kaballian/IOT_F26_PROJ/report/forside.tex

\begin{titlepage}
\begin{center}

\vspace*{2cm}



\vspace{1.5cm}

{\huge \textbf{
\hrulefill \\
Internet of things technology \\
\hrulefill
}}

\vspace{1cm}

{\Large \textbf{IOT  mini-project}}

\vspace{2cm}

\resizebox{17cm}{!}{
\begin{tabular}{lllc}
     \textbf{Name} & \textbf{Initials} & \textbf{Student number} & \textbf{Direction} \\
     \toprule
     Alexander Nygaard Thomsen & AT & 201911329 & E \\
     Jeppe Bangshaab Christensen & JBC & 202106888 & CE\\
\end{tabular}
}

\vspace{1.5cm}

{\Large Due date: 26/05/2026}

\vfill

\end{center}
\end{titlepage}
