kaballian/IOT_F26_PROJ/docs/forside.tex

\begin{center}
    \begin{figure}
        \centering
        
        \label{fig:logo}
    \end{figure}

\vspace*{1cm}
\huge  
\textbf{\hrulefill \\ IOT techonolgy mini project proposal\\ \hrulefill}
\Large
\textbf{\\ }
\vspace{0.5cm}

\LARGE
%\textbf{Aarhus Universitet\\}
\vspace{0.7cm}
\resizebox{17cm}{!}{
\begin{tabular}{lllc}
     \multicolumn{4}{c}{}\\
     \\
     \textbf{Name} & \textbf{Initials} & \textbf{Student number} & \textbf{Retning}\\
     \toprule
        Alexander Nygaard Thomsen & AT & 201911329 & E\\
        Jeppe Bangshaab christensen & JBC & 202106888 & CE\\
        
    % \toprule
    % \textbf{Lecturer: }  \\
\toprule
\\
    proposal date: 22/03/2026 \\
\end{tabular}
}
\end{center}
\newpage
