kaballian/IOT_F26_PROJ/IOT_AIR_FILTER_PROJ_pic.png

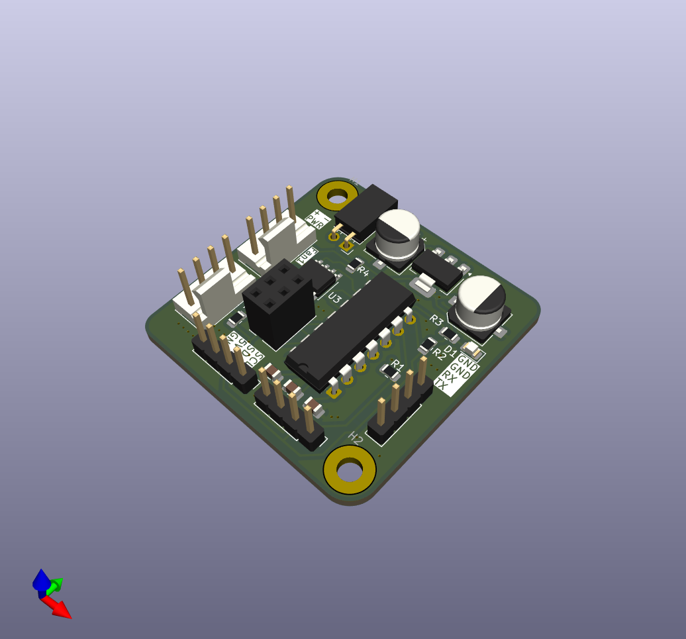
IOT_AIR_FILTER_PROJ_pic.png
