kaballian/IOT_F26_PROJ/IOT_AIR_FILTER_PROJ_REV_B/IOT_AIR_FILTER_PROJ_picture.png

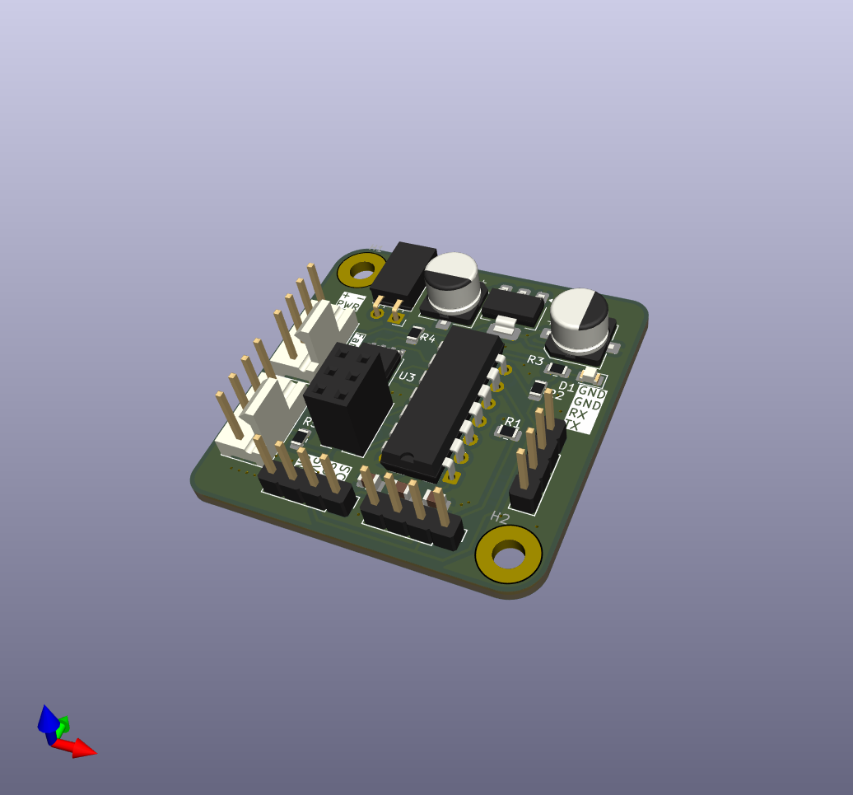
IOT_AIR_FILTER_PROJ_REV_B/IOT_AIR_FILTER_PROJ_picture.png
