kaballian/IOT_F26_PROJ/IOT_AIR_FILTER_SENSOR_SCHEMATIC.png

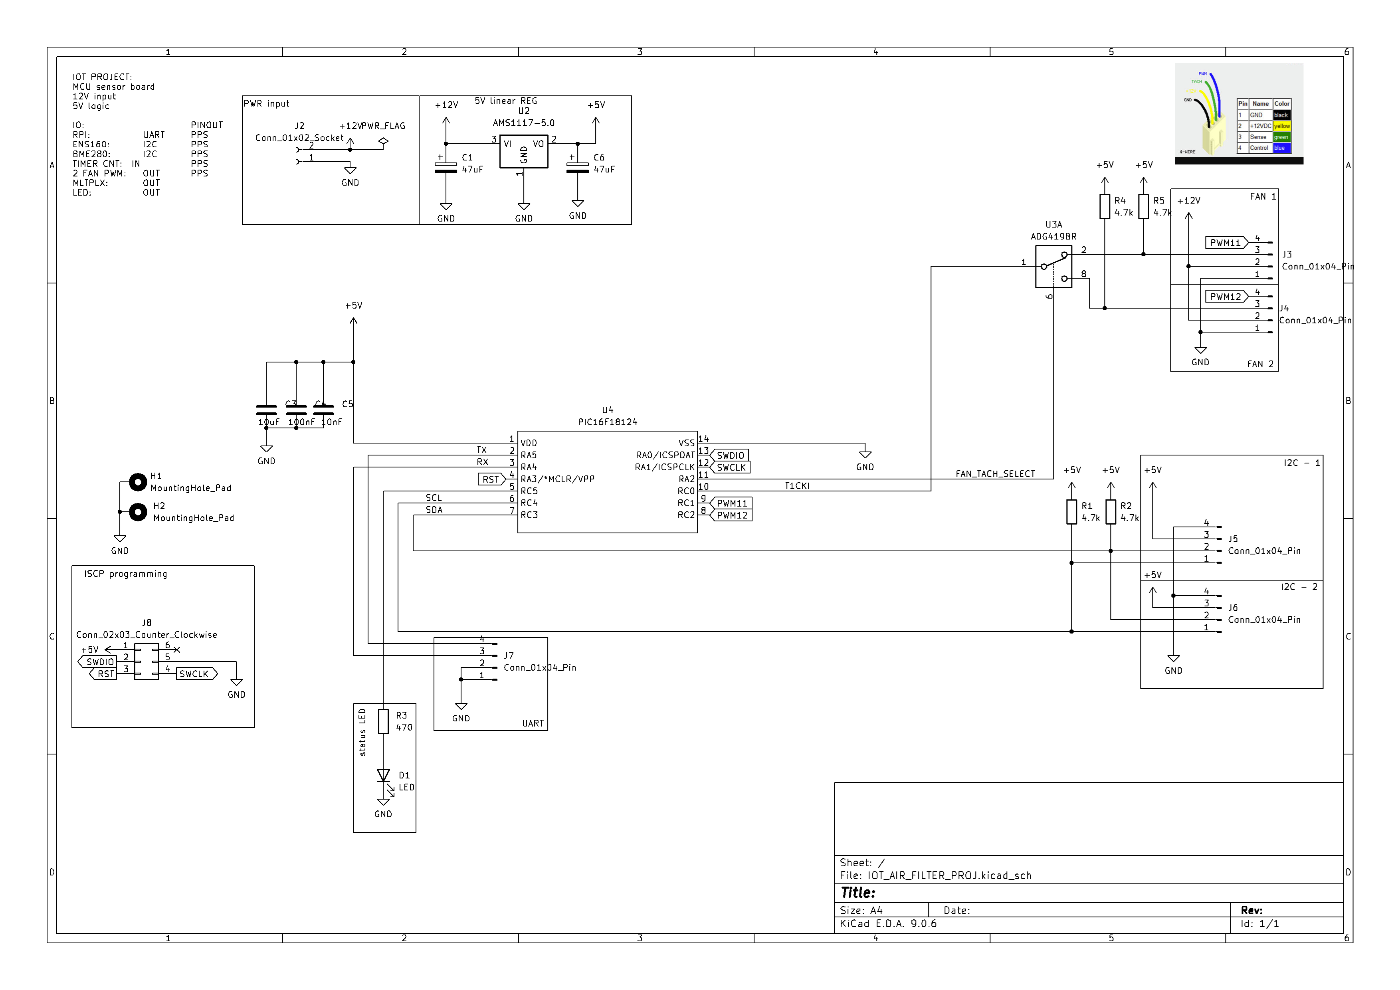
IOT_AIR_FILTER_SENSOR_SCHEMATIC.png
