kaballian/IOT_F26_PROJ/IOT_AIR_FILTER_PROJ_REV_B/subsys_schematic.pdf

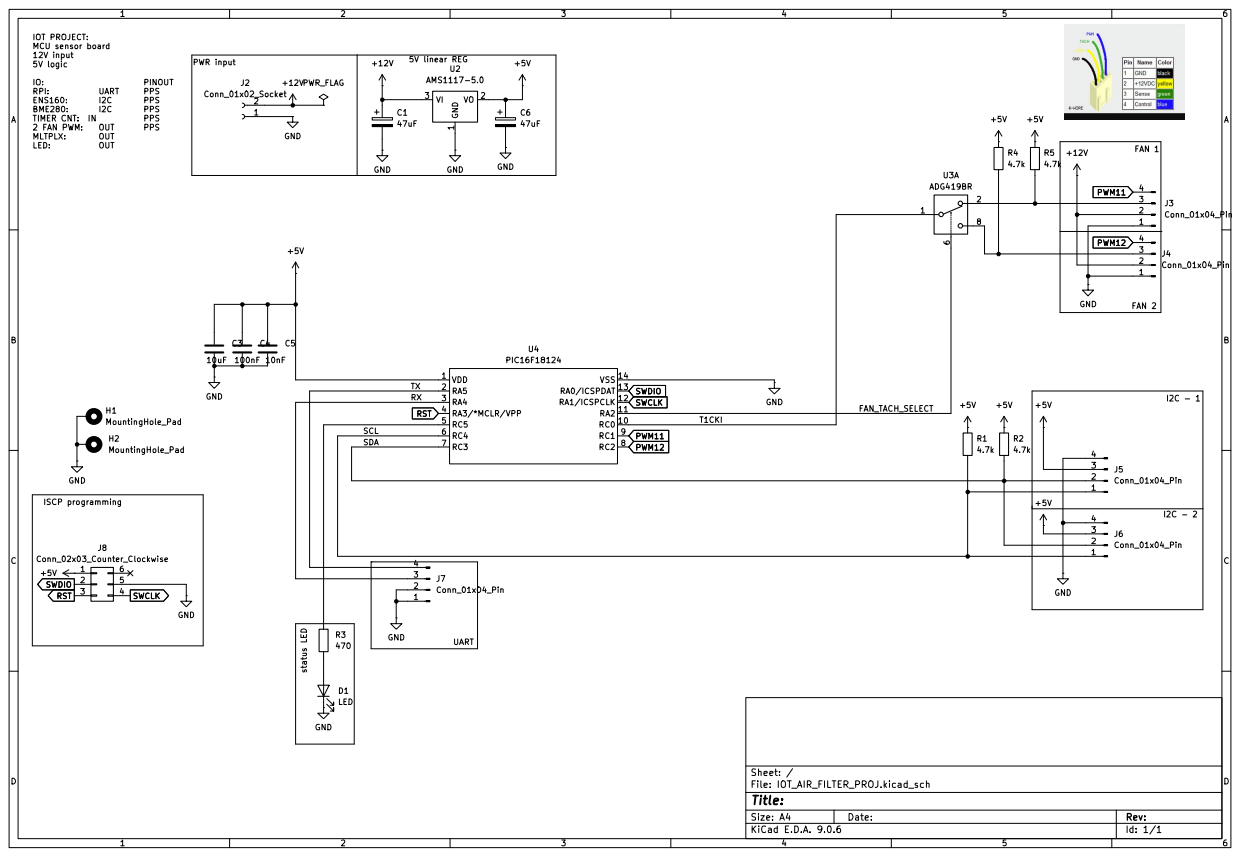
[picture p4: page 1]
