kaballian/IOT_F26_PROJ/IOT_AIR_FILTER_PROJ_REV_B/IOT_AIR_FILTER_PROJ.kicad_pcb

## KiCad design IOT_AIR_FILTER_PROJ_REV_B/IOT_AIR_FILTER_PROJ.kicad_pcb (2026-08-22)

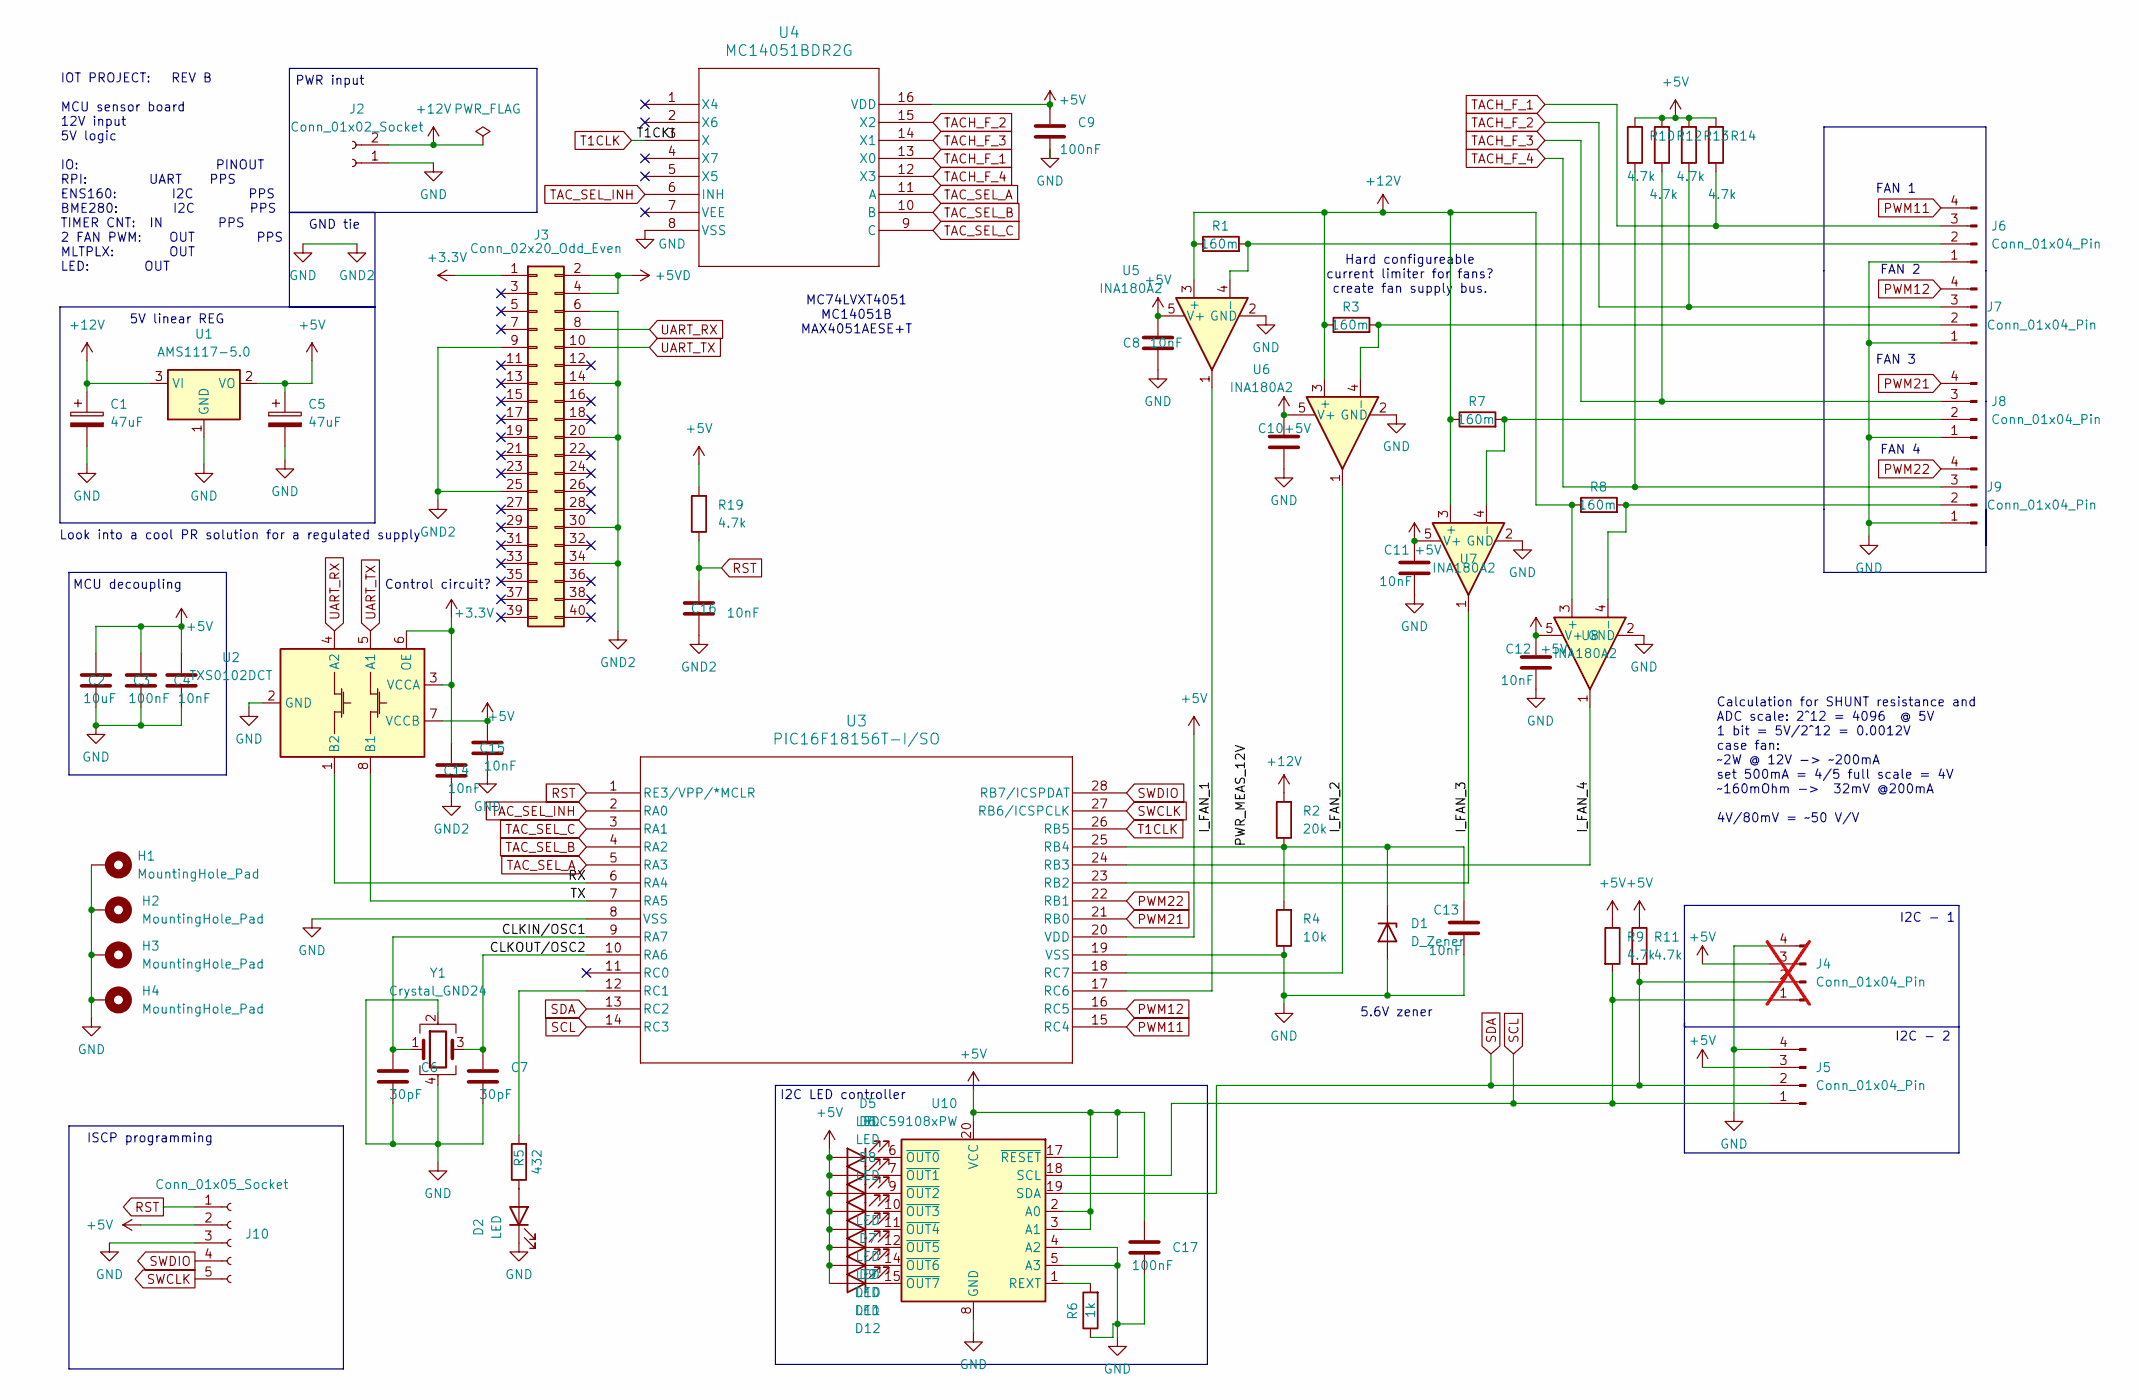
[picture p5: schematic IOT_AIR_FILTER_PROJ.kicad_sch]

Parts:
C1, C5: 47uF; CP_Elec_6.3x5.4
C2: 10uF; C_0805_2012Metric
C3, C9, C17: 100nF; C_0805_2012Metric
C4, C8, C10, C11, C12, C13, C14, C15, C16: 10nF; C_0805_2012Metric
C6, C7: 30pF; C_0805_2012Metric
D1: D_Zener; D_SOD-323
D2, D5, D6, D7, D8, D9, D10, D11, D12: LED; LED_0805_2012Metric_Pad1.15x1.40mm_HandSolder
H1, H2, H3, H4: MountingHole_Pad; MountingHole_2.5mm_Pad
J2: Conn_01x02_Socket; PinSocket_1x02_P2.54mm_Horizontal
J3: Conn_02x20_Odd_Even; PinSocket_2x20_P2.54mm_Vertical
J4: Conn_01x04_Pin; JST_GH_SM04B-GHS-TB_1x04-1MP_P1.25mm_Horizontal; not fitted
J5: Conn_01x04_Pin; JST_GH_SM04B-GHS-TB_1x04-1MP_P1.25mm_Horizontal
J6, J7, J8, J9: Conn_01x04_Pin; FanPinHeader_1x04_P2.54mm_Vertical
J10: Conn_01x05_Socket; JST_GH_SM05B-GHS-TB_1x05-1MP_P1.25mm_Horizontal
R1, R3, R7, R8: 160m; R_1210_3225Metric
R2: 20k; R_0805_2012Metric
R4: 10k; R_0805_2012Metric
R5: 432; R_0402_1005Metric
R6: 1k; R_1210_3225Metric
R9, R10, R11, R12, R13, R14, R19: 4.7k; R_0805_2012Metric
U1: AMS1117-5.0; SOT-223-3_TabPin2
U2: TXS0102DCT; SSOP-8_2.95x2.8mm_P0.65mm
U3: PIC16F18156T-I/SO; SOIC28_SO_MCH
U4: MC14051BDR2G; SOIC-16_ONS
U5, U6, U7, U8: INA180A2; SOT-23-5
U10: TLC59108xPW; TSSOP-20_4.4x6.5mm_P0.65mm
Y1: Crystal_GND24; Crystal_SMD_SeikoEpson_FA238-4Pin_3.2x2.5mm_HandSoldering

Connections:
+3.3V: C14.1, J3.1, U2.3 (VCCA), U2.6 (OE)
+5V: C2.1, C3.1, C4.1, C5.1, C8.1, C9.1, C10.1, C11.1, C12.1, C15.1, C17.1, D5.2 (A), D6.2 (A), D7.2 (A), D8.2 (A), D9.2 (A), D10.2 (A), D11.2 (A), D12.2 (A), J4.3, J5.3, J10.2, R9.1, R10.1, R11.1, R12.1, R13.1, R14.1, R19.2, U1.2 (VO), U2.7 (VCCB), U3.20 (VDD), U4.16 (VDD), U5.5 (V+), U6.5 (V+), U7.5 (V+), U8.5 (V+), U10.2 (A0), U10.3 (A1), U10.17 (~RESET), U10.20 (VCC)
+5VD: J3.2, J3.4
+12V: C1.1, J2.2, R1.1, R2.2, R3.1, R7.1, R8.1, U1.3 (VI), U5.3 (+), U6.3 (+), U7.3 (+), U8.3 (+)
/CLKIN/OSC1: C6.1, U3.9 (RA7), Y1.1
/CLKOUT/OSC2: C7.1, U3.10 (RA6), Y1.3
/I_FAN_1: U3.17 (RC6), U5.1
/I_FAN_2: U3.18 (RC7), U6.1
/I_FAN_3: U3.23 (RB2), U7.1
/I_FAN_4: U3.24 (RB3), U8.1
/PWR_MEAS_12V: C13.1, D1.1 (K), R2.1, R4.2, U3.25 (RB4)
/RX: U2.1 (B2), U3.6 (RA4)
/TX: U2.8 (B1), U3.7 (RA5)
GND: C1.2, C2.2, C3.2, C4.2, C5.2, C6.2, C7.2, C8.2, C9.2, C10.2, C11.2, C12.2, C13.2, C14.2, C15.2, C16.2, C17.2, D1.2 (A), D2.1 (K), H1.1, H2.1, H3.1, H4.1, J2.1, J3.6, J3.9, J3.14, J3.20, J3.25, J3.30, J3.34, J4.4, J5.4, J6.1, J7.1, J8.1, J9.1, J10.3, R4.1, R6.1, U1.1 (GND), U2.2 (GND), U3.8 (VSS), U3.19 (VSS), U4.8 (VSS), U5.2 (GND), U6.2 (GND), U7.2 (GND), U8.2 (GND), U10.4 (A2), U10.5 (A3), U10.8 (GND), U10.13 (GND), U10.16 (GND), Y1.2, Y1.4
unnamed: D2.2 (A), R5.1
unnamed: D5.1 (K), U10.6 (~OUT0)
unnamed: D6.1 (K), U10.7 (~OUT1)
unnamed: D7.1 (K), U10.9 (~OUT2)
unnamed: D8.1 (K), U10.10 (~OUT3)
unnamed: D9.1 (K), U10.11 (~OUT4)
unnamed: D10.1 (K), U10.12 (~OUT5)
unnamed: D11.1 (K), U10.14 (~OUT6)
unnamed: D12.1 (K), U10.15 (~OUT7)
unnamed: J6.2, R1.2, U5.4 (-)
unnamed: J7.2, R3.2, U6.4 (-)
unnamed: J8.2, R7.2, U7.4 (-)
unnamed: J9.2, R8.2, U8.4 (-)
unnamed: R5.2, U3.12 (RC1)
unnamed: R6.2, U10.1 (REXT)
PWM11: J6.4, U3.15 (RC4)
PWM12: J7.4, U3.16 (RC5)
PWM21: J8.4, U3.21 (RB0)
PWM22: J9.4, U3.22 (RB1)
RST: C16.1, J10.1, R19.1, U3.1 (RE3/VPP/*MCLR)
SCL: J4.1, J5.1, R9.2, U3.14 (RC3), U10.18 (SCL)
SDA: J4.2, J5.2, R11.2, U3.13 (RC2), U10.19 (SDA)
SWCLK: J10.5, U3.27 (RB6/ICSPCLK)
SWDIO: J10.4, U3.28 (RB7/ICSPDAT)
T1CLK: U3.26 (RB5), U4.3 (X)
TACH_F_1: J6.3, R14.2, U4.13 (X0)
TACH_F_2: J7.3, R13.2, U4.15 (X2)
TACH_F_3: J8.3, R12.2, U4.14 (X1)
TACH_F_4: J9.3, R10.2, U4.12 (X3)
TAC_SEL_A: U3.5 (RA3), U4.11 (A)
TAC_SEL_B: U3.4 (RA2), U4.10 (B)
TAC_SEL_C: U3.3 (RA1), U4.9 (C)
TAC_SEL_INH: U3.2 (RA0), U4.6 (INH)
UART_RX: J3.8, U2.4 (A2)
UART_TX: J3.10, U2.5 (A1)

Notes on the sheet:
GND tie
5.6V zener
Calculation for SHUNT resistance and ADC scale: 2^12 = 4096 @ 5V 1 bit = 5V/2^12 = 0.0012V case fan: ~2W @ 12V -> ~200mA set 500mA = 4/5 full scale = 4V ~160mOhm -> 32mV @200mA 4V/80mV = ~50 V/V
MCU decoupling
FAN 1
FAN 2
FAN 4
5V linear REG
Look into a cool PR solution for a regulated supply
MC74LVXT4051 MC14051B MAX4051AESE+T
PWR input
Control circuit?
Hard configureable current limiter for fans? create fan supply bus.
IOT PROJECT: REV B MCU sensor board 12V input 5V logic IO: PINOUT RPI: UART PPS ENS160: I2C PPS BME280: I2C PPS TIMER CNT: IN PPS 2 FAN PWM: OUT PPS MLTPLX: OUT LED: OUT
I2C - 1
ISCP programming
I2C LED controller
I2C - 2
FAN 3

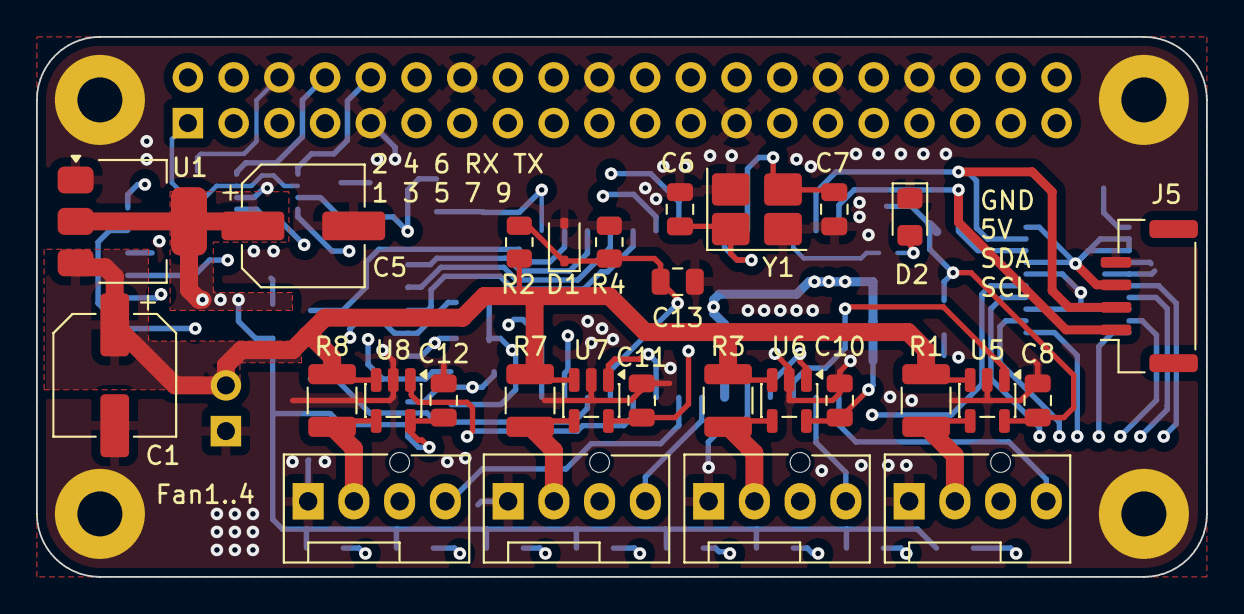
[picture p6: board IOT_AIR_FILTER_PROJ_REV_B/IOT_AIR_FILTER_PROJ.kicad_pcb from above]

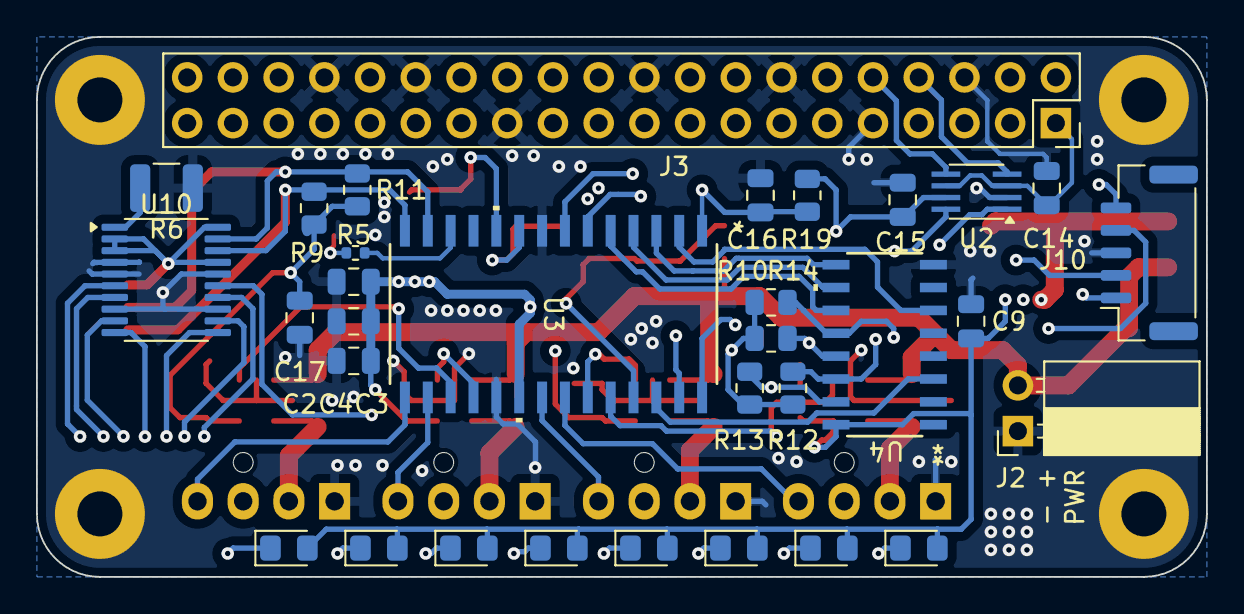
[picture p7: board IOT_AIR_FILTER_PROJ_REV_B/IOT_AIR_FILTER_PROJ.kicad_pcb from below]

Board: 4 copper layers, 65.0 x 30.0 mm, 64 parts (32 on the bottom side), 49 nets.
