kaballian/IOT_F26_PROJ/IOT_AIR_FILTER_PROJ/IOT_AIR_FILTER_PROJ.kicad_pcb

## KiCad design IOT_AIR_FILTER_PROJ/IOT_AIR_FILTER_PROJ.kicad_pcb (2026-05-04, an earlier design)

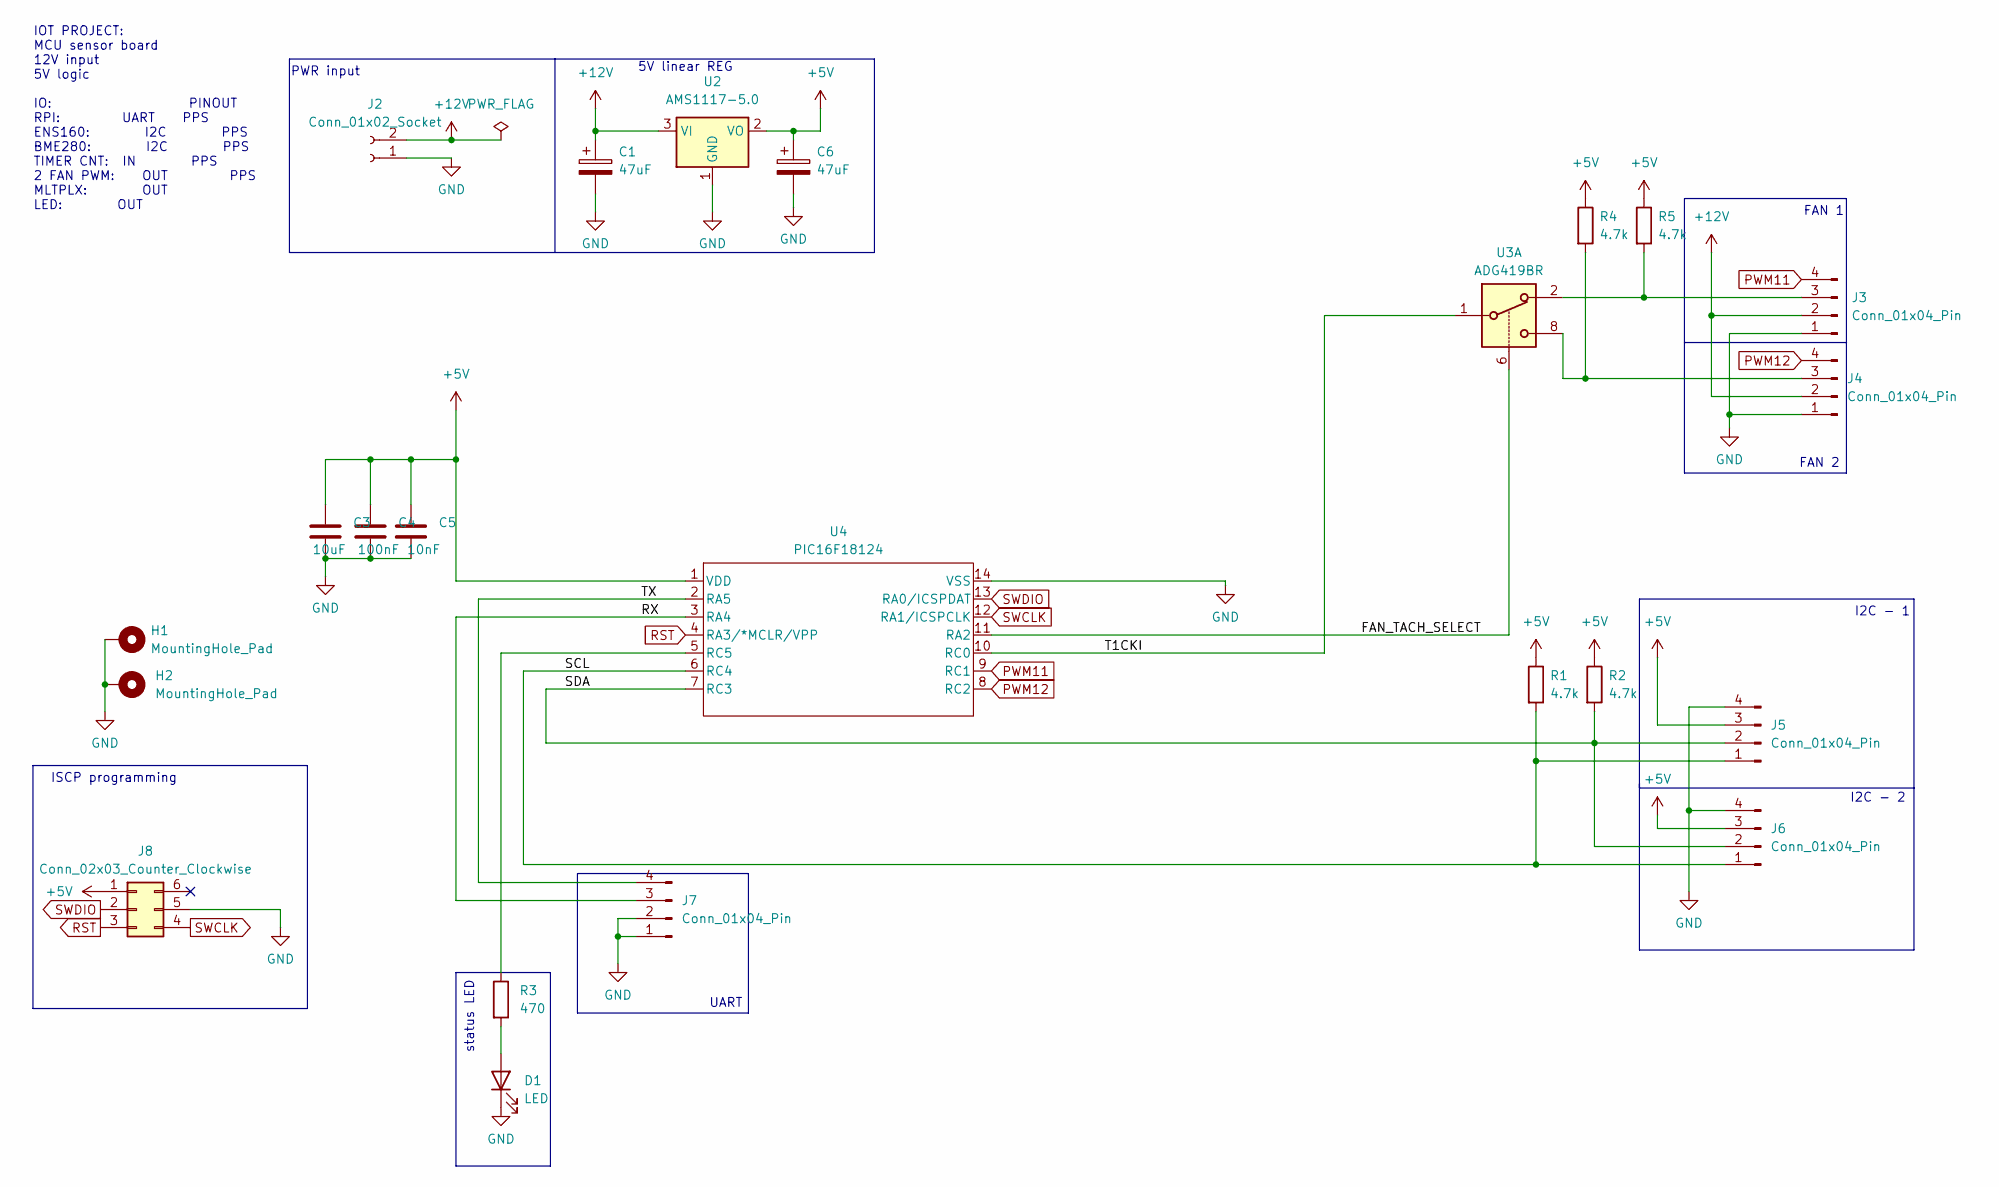
[picture p8: schematic IOT_AIR_FILTER_PROJ.kicad_sch]

Parts:
C1, C6: 47uF; CP_Elec_6.3x5.4
C3: 10uF; C_0805_2012Metric
C4: 100nF; C_0805_2012Metric
C5: 10nF; C_0805_2012Metric
D1: LED; LED_0805_2012Metric
H1, H2: MountingHole_Pad; MountingHole_3.2mm_M3_Pad
J2: Conn_01x02_Socket; PinSocket_1x02_P2.54mm_Horizontal
J3, J4: Conn_01x04_Pin; FanPinHeader_1x04_P2.54mm_Vertical
J5, J6, J7: Conn_01x04_Pin; PinHeader_1x04_P2.54mm_Vertical
J8: Conn_02x03_Counter_Clockwise; PinSocket_2x03_P2.54mm_Vertical
R1, R2, R4, R5: 4.7k; R_0805_2012Metric
R3: 470; R_0805_2012Metric
U2: AMS1117-5.0; SOT-223-3_TabPin2
U3: ADG419BR; SOIC-8_3.9x4.9mm_P1.27mm
U4: PIC16F18124; DIP-14_W7.62mm

Connections:
+5V: C3.1, C4.1, C5.1, C6.1, J5.3, J6.3, J8.1, R1.1, R2.1, R4.1, R5.1, U2.2 (VO), U4.1 (VDD)
+12V: C1.1, J2.2, J3.2, J4.2, U2.3 (VI)
/FAN_TACH_SELECT: U3.6, U4.11 (RA2)
/RX: J7.3, U4.3 (RA4)
/SCL: J5.1, J6.1, R1.2, U4.6 (RC4)
/SDA: J5.2, J6.2, R2.2, U4.7 (RC3)
/T1CKI: U3.1, U4.10 (RC0)
/TX: J7.4, U4.2 (RA5)
GND: C1.2, C3.2, C4.2, C5.2, C6.2, D1.1 (K), H1.1, H2.1, J2.1, J3.1, J4.1, J5.4, J6.4, J7.1, J7.2, J8.5, U2.1 (GND), U4.14 (VSS)
unnamed: D1.2 (A), R3.2
unnamed: J3.3, R5.2, U3.2
unnamed: J4.3, R4.2, U3.8
unnamed: R3.1, U4.5 (RC5)
PWM11: J3.4, U4.9 (RC1)
PWM12: J4.4, U4.8 (RC2)
RST: J8.3, U4.4 (RA3/*MCLR/VPP)
SWCLK: J8.4, U4.12 (RA1/ICSPCLK)
SWDIO: J8.2, U4.13 (RA0/ICSPDAT)

Notes on the sheet:
UART
FAN 1
FAN 2
5V linear REG
status LED
PWR input
IOT PROJECT: MCU sensor board 12V input 5V logic IO: PINOUT RPI: UART PPS ENS160: I2C PPS BME280: I2C PPS TIMER CNT: IN PPS 2 FAN PWM: OUT PPS MLTPLX: OUT LED: OUT
I2C - 1
ISCP programming
I2C - 2

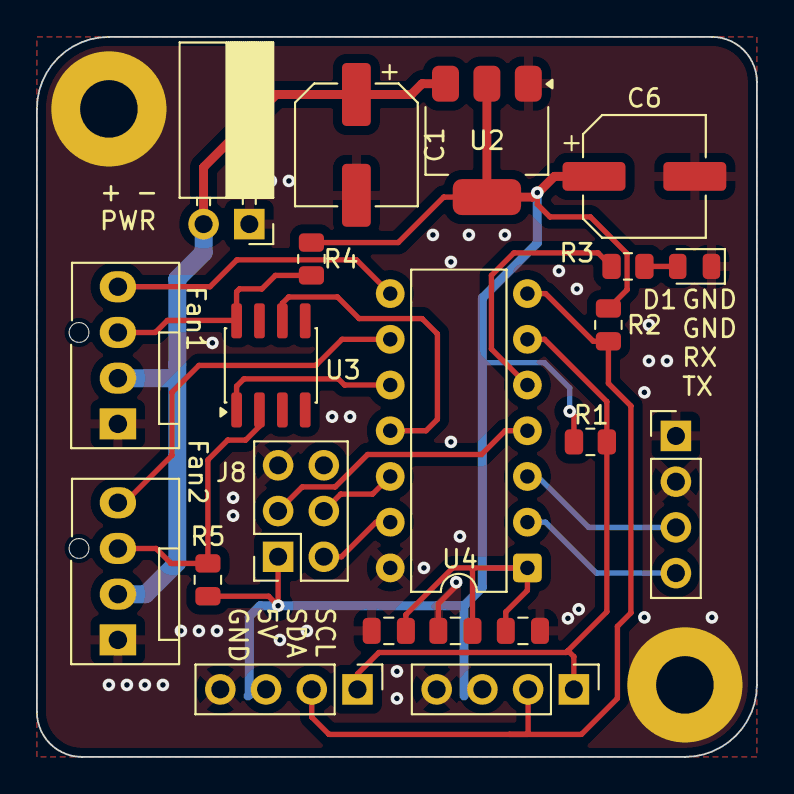
[picture p9: board IOT_AIR_FILTER_PROJ/IOT_AIR_FILTER_PROJ.kicad_pcb from above]

Board: 2 copper layers, 40.0 x 40.0 mm, 23 parts (0 on the bottom side), 18 nets.
