kaballian/IOT_F26_PROJ/FW/IOT_DEV_SENSOR.X/src/eusart1.c

#include "include/eusart1.h"
#include "include/parse.h"
#include <pic16f18124.h>


#define UART_RX_BUF_SIZE    32u
#define UART_TX_BUF_SIZE    32u


/*parser states*/




extern volatile uint8_t g_uart_rx_f; //set in the ISR and consumed in the APP layer
extern volatile uint8_t g_uart_rx_msg_r;
volatile uint8_t END_REG = 0;

// static volatile uint8_t rx_buf[UART_RX_BUF_SIZE];
// static volatile uint8_t rx_head = 0;
// static volatile uint8_t rx_tail = 0;
// static volatile uint8_t tx_buf[UART_TX_BUF_SIZE];
// static volatile uint8_t tx_head = 0;
// static volatile uint8_t tx_tail = 0;

static volatile const UART_tx_msg_t *g_tx_msg = 0;
static volatile uint8_t g_tx_idx = 0;

volatile bool g_comm_tx_done_f = false;

bool COMM_tx_done(void)
{
    return g_comm_tx_done_f;
}
void COMM_clear_tx_done(void)
{
    g_comm_tx_done_f = false;
}

static uint8_t next_index(uint8_t index, uint8_t size)
{
    /*helper for ring buffer*/
    index++; //advances the index (rx or tx)
    if(index >= size)
    {
        index = 0;
    }
    return index;
}

void EUSART1_init(void)
{
    TX1REG      = 0x0;
    BAUD1CON    = 0x40;
    RC1STA      = 0x0;
    TX1STA      = 0x22;
    SP1BRGL     = 0x0;
    SP1BRGH     = 0x0;

    //baud generator 16 bit high speed
    BAUD1CONbits.BRG16 = 1;
    TX1STAbits.BRGH = 1;

    //async mode
    TX1STAbits.SYNC = 0;

    //enable serial port
    RC1STAbits.SPEN = 1;

    //enable TX and RX
    TX1STAbits.TXEN = 1;
    RC1STAbits.CREN = 1;

    //8 bits mode
    TX1STAbits.TX9 = 0;
    RC1STAbits.RX9 = 0;
    // //9600 baud @ 16 MHZ
    SP1BRGH = 0x01;
    SP1BRGL = 0xA0; //~416

   

    

    UART_RX_Parserinit();
}



void EUSART1_ISR(void)
{
    

    /*RX error recovery*/
    if(RC1STAbits.OERR) //overrun error, cleared by clearing SPEN or CREN
    {
        RC1STAbits.CREN = 0;
        RC1STAbits.CREN = 1;
    }

    /*RX*/
    if(PIR4bits.RC1IF)
    {   
        /*read data from receive buffer
        this also clears RC1IF flag automatically sec 12.10.13*/
        // uint8_t byte = RC1REG; 
       
        volatile uint8_t byte = RC1REG;

        //LATCbits.LATC5 = 1;

        // static UART_tx_msg_t tx_msg;
        // tx_msg.cmd = CMD_PING;
        // tx_msg.len = 0;

        // COMM_assemble_frame(&tx_msg);
        // COMM_TX_start(&tx_msg);

        UART_RX_ParserFeed(byte);
    }

    /*TX*/
    /*sec 12.10.13*/ 
    if(PIR4bits.TX1IF)
    {
        if(g_tx_msg && (g_tx_idx < g_tx_msg->frame_len))
        {
            TX1REG = g_tx_msg->frame[g_tx_idx++]; 
        }else{ /*when transmission is complete or pointer is null*/
            PIE4bits.TX1IE = 0; /*stop the TX interrupts*/
            g_tx_msg = 0; /*reset message*/
            g_tx_idx = 0; /*reset index counter for payload*/
        
            g_comm_tx_done_f = true; /*indicate that transmission is done*/
        }
    }
}


void COMM_assemble_frame(UART_tx_msg_t *tx)
{
    uint8_t i = 0;
    tx->frame[i++] = SOF; /*start of frame*/
    tx->frame[i++] = tx->cmd;
    tx->frame[i++] = tx->len;

    for(uint8_t j = 0; j < tx->len; j++)
    {
        tx->frame[i++] = tx->payload[j];
    }

    tx->frame[i++] = UART_CHKSUM(tx->cmd, tx->len, tx->payload);
    tx->frame[i++] = END1;
    tx->frame[i++] = END2;
    tx->frame_len = i;
}
void COMM_TX_start(UART_tx_msg_t *tx)
{
    g_tx_msg = tx;
    g_tx_idx = 0;
    g_comm_tx_done_f = 0;
    PIE4bits.TX1IE = 1; /*kick the ISR into action*/ 
}
