kaballian/IOT_F26_PROJ/FW/IOT_DEV_SENSOR.X/include/system.h

#ifndef SYSTEM_H
#define SYSTEM_H
#include <stdint.h>
#include <xc.h>
#include "utils.h"
#include "include/clock.h"
#include "include/pins.h"



#include "FAN.h"
#include "EXT_SENSOR.h"
#include "include/ENS_160.h"
#include "include/I2C.h"
#include "include/FAN.h"
#include "include/PWM.h"
#include "include/eusart1.h"
#include "include/ADG419BR.h"
#include "include/TMR0.h"
#include "include/TMR1.h"
#include "include/interrupt.h"
#include "include/parse.h"

//DEBUG UART FLAG
#define DEBUG_UART_TRACE 0


#define FAN_TO_CHL(fan) ((switch_chl_t)(fan)) //casts fan_sel_t -> switch_chl_t




/*
IOT PROJECT:
AIR PARTICLE SENSOR FIRMWARE
SYSTEM.h
*/
/*simple statemachine*/

void SYSTEM_init(void);


//events
typedef enum{
    None,
    TMRTick,
    UARTTIMEOUT,
    UART,
    UART_RESP,
    MEAS_FAN_START,
    MEAS_FAN1_START,
    MEAS_FAN2_START,
    MEAS_FAN_DONE,
    MEAS_FAN1_DONE,
    MEAS_FAN2_DONE,
    MEAS_ENS160_START,
    MEAS_ENS160_PROBE,
    MEAS_ENS160_STAT,
    MEAS_ENS160_READ,
    MEAS_ENS160_DONE,
    MEAS_BME280,
    I2C_ERR,
    INIT_COMP,
    TMR_START,
    CONV_START,
    CONV_DONE,
    PWM_SET,
    UART_PARSE_RX,
    SET_F1,
    SET_FAN,
    SET_DONE,
    COMM_TX_DONE,
}event_t;
//states
// typedef enum{
//     ST_INIT = 0,
//     ST_IDLE,
//     ST_MEAS,
//     ST_MEAS_FAN,
//     ST_MEAS_F1,
//     ST_MEAS_F2,
//     ST_SET_FAN,
//     ST_SET_F1,
//     ST_SET_F2,
//     ST_MEAS_ENS160,
//     ST_COMM,
//     ST_COUNT
// }state_t;

typedef enum{
    ST_IDLE,
    ST_MEAS_FAN,
    ST_MEAS_ENS160,
    ST_COMM,
    ST_COUNT
}state_t;

typedef uint8_t flag8_t;

//init flags
typedef enum{
    INIT_INCOMPLETE = 0,
    INIT_PWM1       =(1u<<0),
    INIT_PWM2       =(1u<<1),
    INIT_ENS160     =(1u<<2),
    INIT_BME280     =(1u<<3),
    INIT_STAT_LED   =(1u<<4),
    INIT_UART       =(1u<<5),
    INIT_I2C        =(1u<<6),
}init_f_t;

//faults flags
typedef enum {
    FAULT_NONE      = 0,
    FAULT_FREQ_F1   =(1u<<0),
    FAULT_FREQ_F2   =(1u<<1),
    FAULT_ENS160    =(1u<<2),
    FAULT_BME280    =(1u<<3),
    FAULT_UART      =(1u<<4)
}fault_f_t;


//I2C comm flags
typedef enum{
    // NO_COMM         = 0,
    // COMM_INIT       =(1u<<0),
    // MEAS_RECV       =(2u<<0),
    // STAT_RECV       =(3u<<0),
    // READING_DAT     =(4u<<0),
    // CYCLE_COMP      =(5u<<0)
    NO_COMM = 0,
    COMM_INIT, 
    READ_DATA,
    COMM_COMP
}I2C_COMM_f_t;


typedef struct {
    uint16_t humidity;
    uint16_t pressure;
}BME280_meas;

typedef struct{
    uint16_t AQI; //air quality indicator 
}ENS160_meas;

typedef enum {
    GATE_NONE = 0,
    GATE_F1,
    GATE_F2,
    GATE_ENS160,
    GATE_FAN,
    GATE_F1_SET,
    GATE_F2_SET,
    GATE_FAN_SET,
    GATE_COMM,
}gate_owner_t;

typedef enum{
    FAN_1 = 0,
    FAN_2 = 1,
    FAN_COUNT = 2,
}fan_sel_t;



/*UART response type*/

typedef enum{
    COMM_RESP_NONE = 0,
    COMM_RESP_PING,
    COMM_RESP_STAT,
    COMM_RESP_F1,
    COMM_RESP_F2,
    COMM_RESP_SENSOR,
    COMM_RESP_ERROR
}UART_COMM_resp_t;

/*application service response type*/
typedef struct{
    UART_COMM_resp_t    type;
    uint8_t             arg;
}app_comm_req_t;
//shared data
typedef struct {
    uint32_t    sys_ms;
    uint32_t    fsm_tick;
    uint16_t    fan_gate_div;
    uint32_t    gate_deadline;
    uint8_t     gate_active;
    uint8_t     has_deadline;
    flag8_t     init_flags;
    flag8_t     fault_flags;
    uint16_t    F1_meas[FAN_BUF_LEN];
    uint16_t    F2_meas[FAN_BUF_LEN];
    BME280_meas room_meas[BME280_BUF_LEN];
    ENS160_meas AQI_meas[ENS160_BUF_LEN];
    


    //DEBUG STUFF
    #if DEBUG_UART_TRACE
        uint8_t     dbg_rx_msg;
        uint8_t     dbg_uart_resp_push;
        uint8_t     dbg_comm_entry;
        uint8_t     dbg_tx_start;
        uint8_t     dbg_tx_done_push;
        uint8_t     dbg_q_fail;
    #endif

    uint8_t     meas_head;
    uint8_t     meas_count;

    
    //timer ownership
    gate_owner_t    gate_owner;
    
    //UART comm
    UART_comm_t     UART_CMD;
    app_comm_req_t  comm_req;
    UART_tx_msg_t   tx_msg;

    //i2c comm flags
    I2C_COMM_f_t    comm_i2c_flags;
    //hardware
    ENS160_t        ENS160;
    fan_t           FAN1;
    fan_t           FAN2;
    fan_t           FANS[FAN_COUNT];
    // switch_chl_t    FAN_selector;
    ADG419_t        FAN_selector;    
    fan_sel_t       active_fan;  //either 0(fan1) or 1(fan2)
}context_t;

//state transition
typedef struct {
    bool changed;
    state_t next;
}transition_t;

static transition_t stay(state_t current){
    transition_t t;
    t.changed = false;
    t.next = current;
    return t;
}
static transition_t to(state_t s)
{
    transition_t t = {
        .changed    = true,
        .next       = s
    };
    return t;

}

typedef void        (*state_entry_fn)(context_t *CTX);
//typedef void        (*state_exit_fn)(context_t *CTX);
typedef transition_t(*state_handle_fn)(context_t *CTX, event_t e, state_t current);

typedef struct {
    state_entry_fn  entry;
    //state_exit_fn   exit;
    state_handle_fn handle;
}state_ops_t;
//state machine
typedef struct{
    context_t   CTX;
    state_t     state;
}FSM_t;


void FSM_init(FSM_t *sm);
void FSM_transition(FSM_t *sm, state_t next);
void FSM_dispatch(FSM_t *sm, event_t ev);
//void FSM_UART_debug_transmission(context_t *CTX, state_t old, event_t ev, state_t next);

#endif
