kaballian/IOT_F26_PROJ/FW/IOT_DEV_SENSOR.X/include/TMR1.h

#ifndef TMR1_H
#define TMR1_H

/*timer1 abstraction for using timer 1 as a counter*/
#include "utils.h"

void TMR1_CNT_init(void);
uint16_t TMR1_CNT_meas(void);
void TMR1_CNT_start(void);
void TMR1_CNT_stop(void);
void TMR1_CNT_reset(void);
static uint16_t TMR1_read16(void);

#endif
