kaballian/IOT_F26_PROJ/(commit log)

2026-03-24 GIT cleanup
    [IOT_AIR_FILTER_PROJ.kicad_pcb, IOT_AIR_FILTER_PROJ.kicad_sch]
2026-03-24 schematic design and layout for IOT device
    [IOT_AIR_FILTER_PROJ.kicad_pcb]
2026-03-25 minor changes to schematic, component selection and layout
    [IOT_AIR_FILTER_PROJ.kicad_pcb, IOT_AIR_FILTER_PROJ.kicad_sch]
2026-03-29 added schematics/layout/manufacturing files. Also initial FW for IOT sensor
    [BOM-IOT_AIR_FILTER_PROJ.csv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]
2026-03-30 work into sensor
2026-04-02 defined FAN and PWM
2026-04-02 completed generic I2C driver
2026-04-02 progress into ENS160 driver
2026-04-03 complete I2C driver for ENS160
2026-04-03 complete driver for ADG419BR SPDT switch
2026-04-04 implementation of FAN measurement routing
2026-04-19 application layer for i2c measurement done. TX ISR is next
2026-04-21 added states and functions protos to set fan speed
2026-04-21 reworded UART RX function and parser structure with statemachine
2026-04-24 app_service progress, completed set fan service and FSM
2026-04-25 completed 3 UART TX scenarios, and implemented frame assember
2026-05-04 added raspberry pi stuff
    [IOT_AIR_FILTER_PROJ-CuBottom.gbr, IOT_AIR_FILTER_PROJ-CuTop.gbr, IOT_AIR_FILTER_PROJ-EdgeCuts.gbr, IOT_AIR_FILTER_PROJ-MaskBottom.gbr, IOT_AIR_FILTER_PROJ-MaskTop.gbr, IOT_AIR_FILTER_PROJ-NPTH.drl, IOT_AIR_FILTER_PROJ-PTH.drl, IOT_AIR_FILTER_PROJ-SilkBottom.gbr]
2026-05-14 mayor progress in integration, PWM, TMR0/1, I2C, UART is working
2026-05-22 minor changes to UART reply
2026-07-12 added REV B hardware
    [BOM-IOT_AIR_FILTER_PROJ.csv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]
2026-07-12 added kicad components
2026-08-22 replaced i2c expander with dedicated LED controller
    [IOT_AIR_FILTER_PROJ.kicad_pcb, IOT_AIR_FILTER_PROJ.kicad_sch]
